esaid/files/monitoring.brd

## EAGLE design monitoring.brd (2016-12-23)

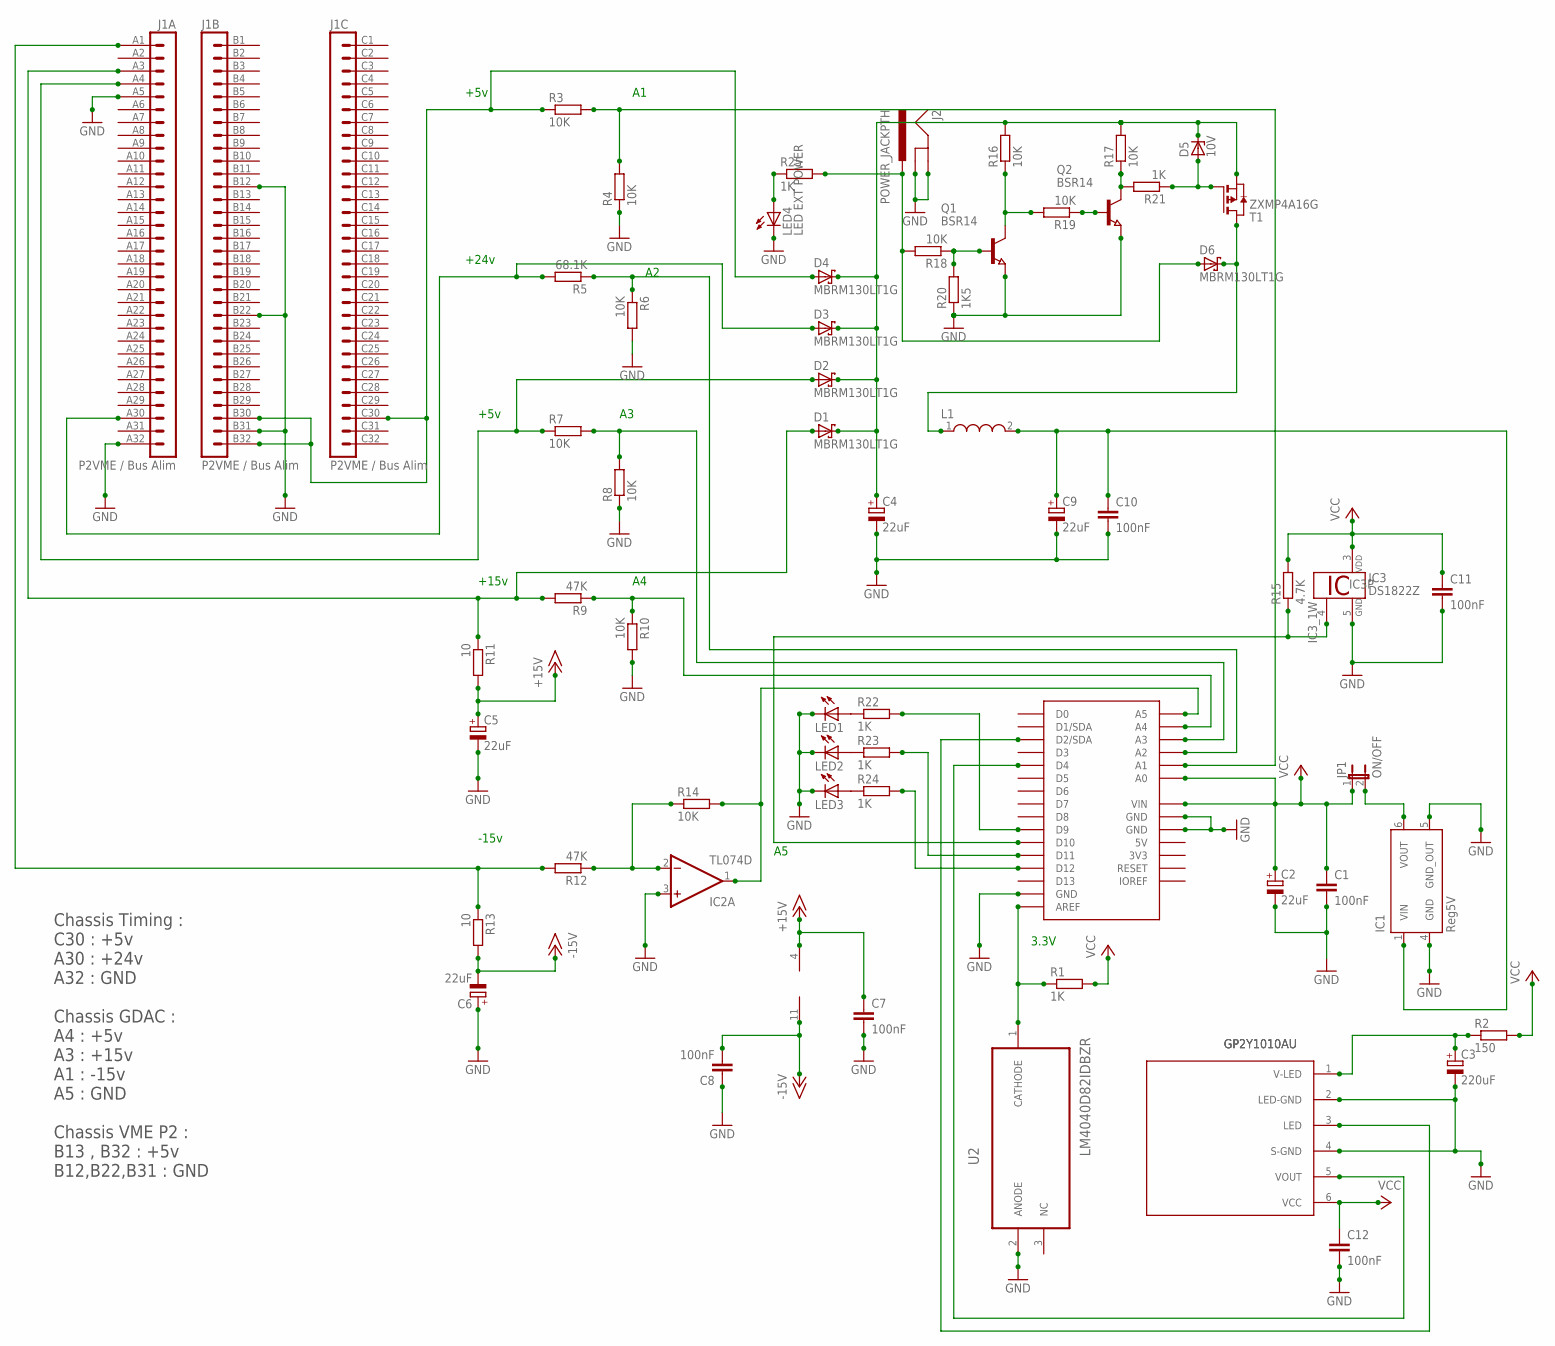
[picture p1: schematic monitoring.sch]

Parts:
C1, C7, C8, C10, C11, C12: 100nF; C1206K
C2, C4, C5, C6, C9: 22uF; CT7343
C3: 220uF; 150CLZ-0810
D1, D2, D3, D4, D6: MBRM130LT1G; DIODE_SMB
D5: 10V; SMB
IC1: Reg5V; REG5V
IC2: TL074D; SO14
IC3: DS1822Z; SO08
J1: P2VME / Bus Alim; VG96
J2: POWER_JACKPTH; POWER_JACK_PTH
JP1: ON/OFF; JP1
L1: WE-UKW_1SW_7427501; WE-UKW_7427501
LED1, LED2, LED3: LED_ELD260; LED_LD260
LED4: LED EXT POWER; LED_LD260
Q1, Q2: BSR14; SOT23
R1, R21, R22, R23, R24, R25: 1K; R1206
R2: 150; R1206
R3, R4, R6, R7, R8, R10, R14, R16, R17, R18, R19: 10K; R1206
R5: 68.1K; R1206
R9, R12: 47K; R1206
R11, R13: 10; R1206
R15: 4.7K; R1206
R20: 1K5; R1206
T1: ZXMP4A16G; SOT223
U1: YUN_SHIELD-BPLACE; YUN_SHIELD
U2: LM4040D82IDBZR; SOT95P237X112-3N
U$1: GP2Y1010AU0F; GP2Y1010AU

Connections:
3V3: U1.3V3
5V: U1.5V
+15V: C5.+, C7.1, IC2.4 (V+), R11.2
-15V: C6.-, C8.2, IC2.11 (V-), R13.2
GND: C1.2, C2.-, C3.-, C4.-, C5.-, C6.+, C7.2, C8.1, C9.-, C10.2, C11.2, C12.2, IC1.4 (GND), IC1.5 (GND_OUT), IC2.3 (+IN), IC3.5 (GND), J1.A5 (5), J1.A32 (32), J1.B12 (12), J1.B22 (22), J1.B31 (31), J2.GND, J2.GNDBREAK, LED1.K (C), LED2.K (C), LED3.K (C), LED4.K (C), Q1.2 (E), Q2.2 (E), R4.1, R6.2, R8.1, R10.2, R20.1, U1.GND@1 (GND), U1.GND@2 (GND), U1.GND@3 (GND), U2.2 (ANODE), U$1.2 (LED-GND), U$1.4 (S-GND)
IOREF: U1.IOREF
unnamed: C3.+, R2.1, U$1.1 (V-LED)
unnamed: IC1.6 (VOUT), JP1.2
unnamed: R1.1, U1.AREF, U2.1 (CATHODE)
unnamed: R3.2, R4.2, U1.A1
unnamed: R5.1, R6.1, U1.A2
unnamed: R7.2, R8.2, U1.A3
unnamed: R9.1, R10.1, U1.A4
unnamed: Q1.1 (B), R18.1, R20.2
unnamed: D3.A (C), J1.A30 (30), R5.2
unnamed: D2.A (C), J1.A4 (4), R7.1
unnamed: D1.A (C), J1.A3 (3), R9.2, R11.1
unnamed: C4.+, D1.C (A), D2.C (A), D3.C (A), D4.C (A), D5.C, R16.2, R17.2, T1.3 (S)
unnamed: D4.A (C), J1.B30 (30), J1.B32 (32), J1.C30 (30), R3.1
unnamed: IC2.2 (-IN), R12.1, R14.1
unnamed: J1.A1 (1), R12.2, R13.1
unnamed: IC2.1 (OUT), R14.2, U1.A5
unnamed: D6.C (A), L1.1, T1.2 (D), T1.4 (D)
unnamed: LED1.A, R22.1
unnamed: C9.+, C10.1, IC1.1 (VIN), L1.2
unnamed: Q2.3 (C), R17.1, R21.2
unnamed: Q2.1 (B), R19.1
unnamed: Q1.3 (C), R16.1, R19.2
unnamed: D5.A, R21.1, T1.1 (G)
unnamed: IC3.4 (1W), R15.1, U1.D10
unnamed: U1.D2 (D2/SDA), U$1.3 (LED)
unnamed: U1.D4, U$1.5 (VOUT)
unnamed: D6.A (C), J2.PWR, R18.2, R25.2
unnamed: LED2.A, R23.1
unnamed: LED3.A, R24.1
unnamed: R22.2, U1.D9
unnamed: LED4.A, R25.1
unnamed: R23.2, U1.D11
unnamed: R24.2, U1.D12
VCC: C1.1, C2.+, C11.1, C12.1, IC3.3 (VDD), JP1.1, R1.2, R2.2, R15.2, U1.A0, U1.VIN, U$1.6 (VCC)

Notes on the sheet:
3.3V
+5v
+24v
+15v
-15v
Chassis Timing : C30 : +5v A30 : +24v A32 : GND Chassis GDAC : A4 : +5v A3 : +15v A1 : -15v A5 : GND Chassis VME P2 : B13 , B32 : +5v B12,B22,B31 : GND
GP2Y1010AU

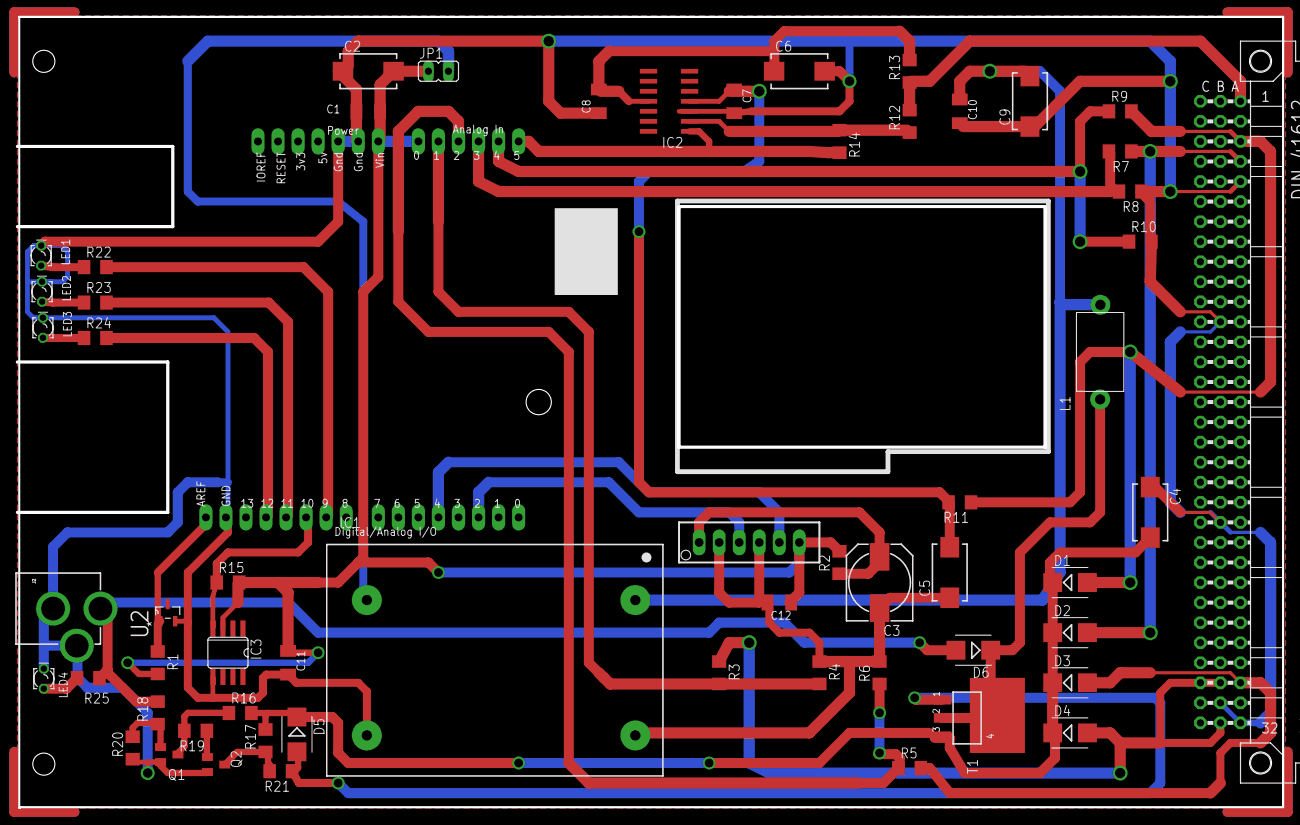
[picture p2: board monitoring.brd from above]

Board: 8 copper layers, 160.1 x 100.2 mm, 60 parts (0 on the bottom side), 37 nets.
