esaid/files/(notices)

Notices in the files:
lib_dust.cpp:
modify it under the terms of the GNU General Public License
parts and their libraries:
Eagle_POWER_MAGNETICS_rev16c: Copyright: Würth Elektronik
SparkFun-Connectors: Licensing: Creative Commons ShareAlike 4.0 International - https://creativecommons.org/licenses/by-sa/4.0
